hamzahaddaoui/Self-Balancing-Robot/Slides.pdf

## Robot auto bilanciante

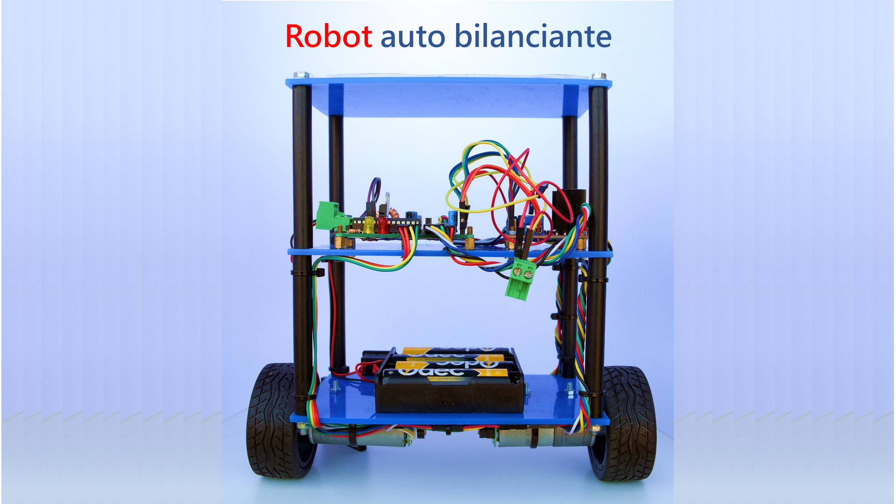
[picture p34: page 1]
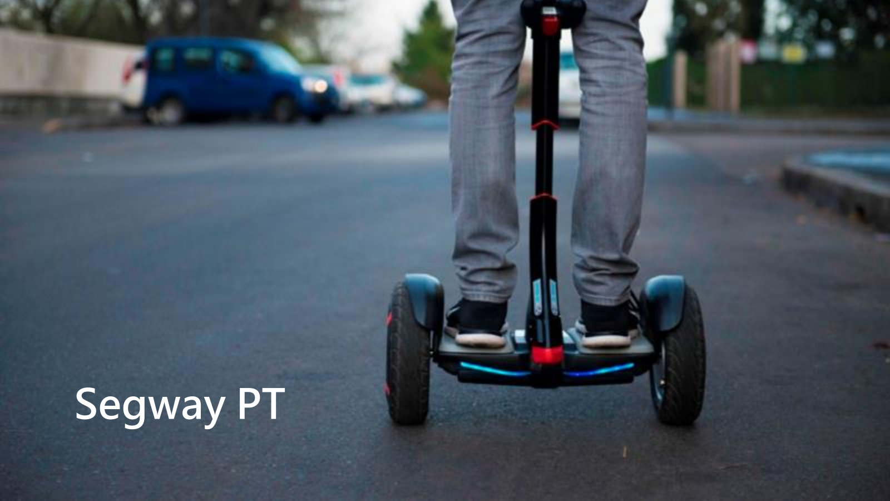
[picture p35: page 2]

# Segway PT

# Honda ASIMO

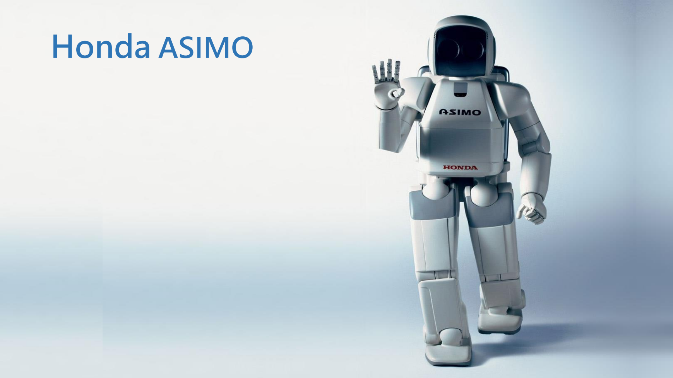
[picture p36: page 3]

# Balanduino

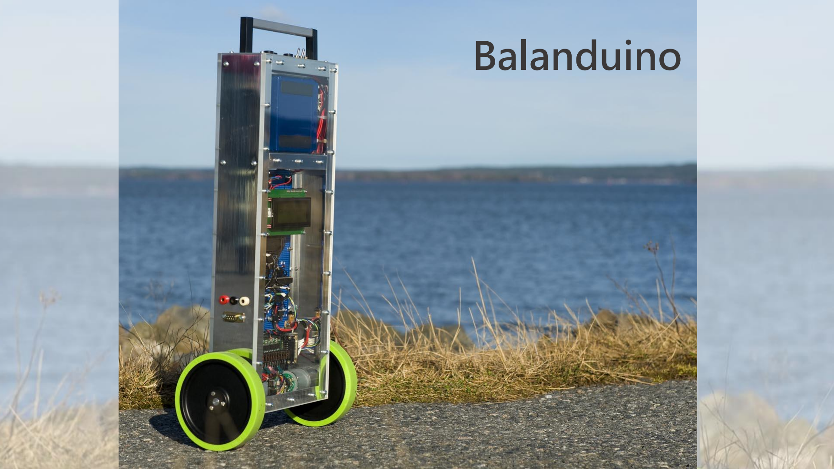
[picture p37: page 4]

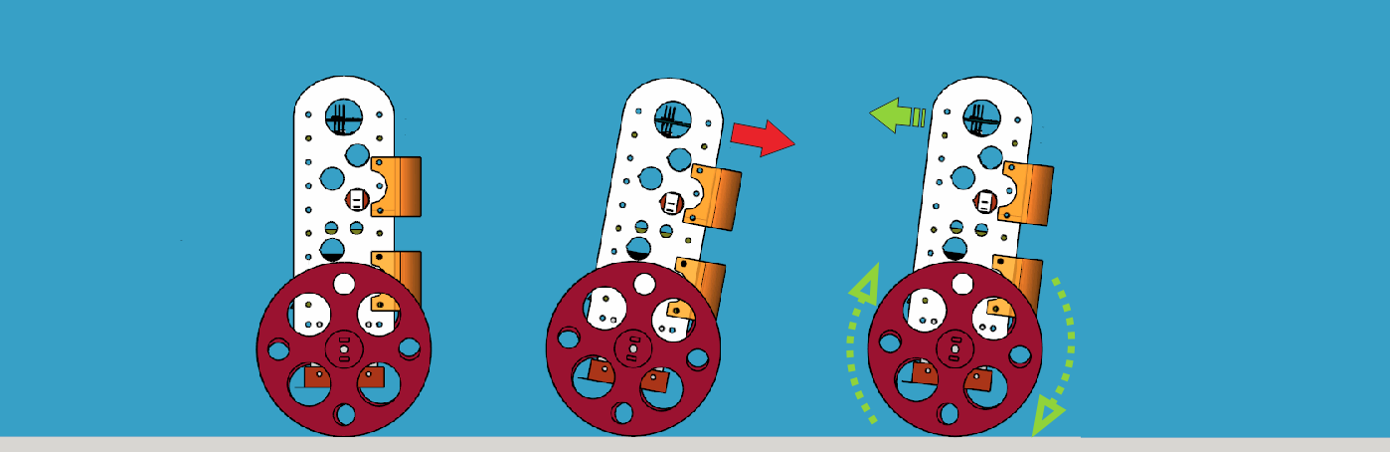
[picture p38: figure]

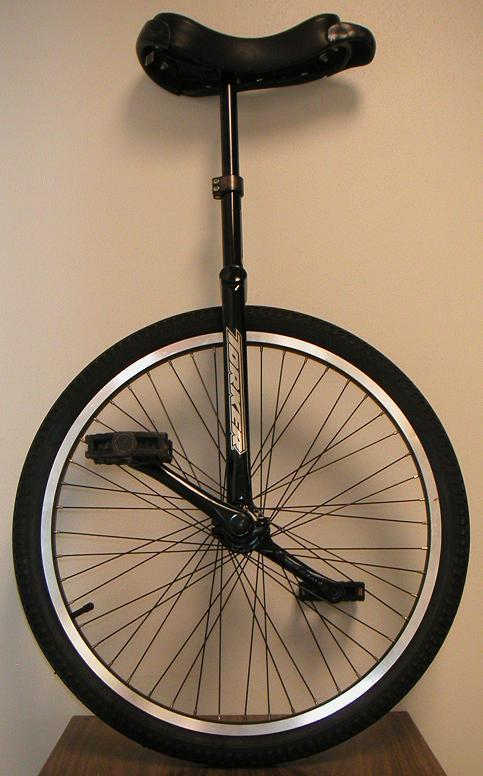
[picture p39: figure]
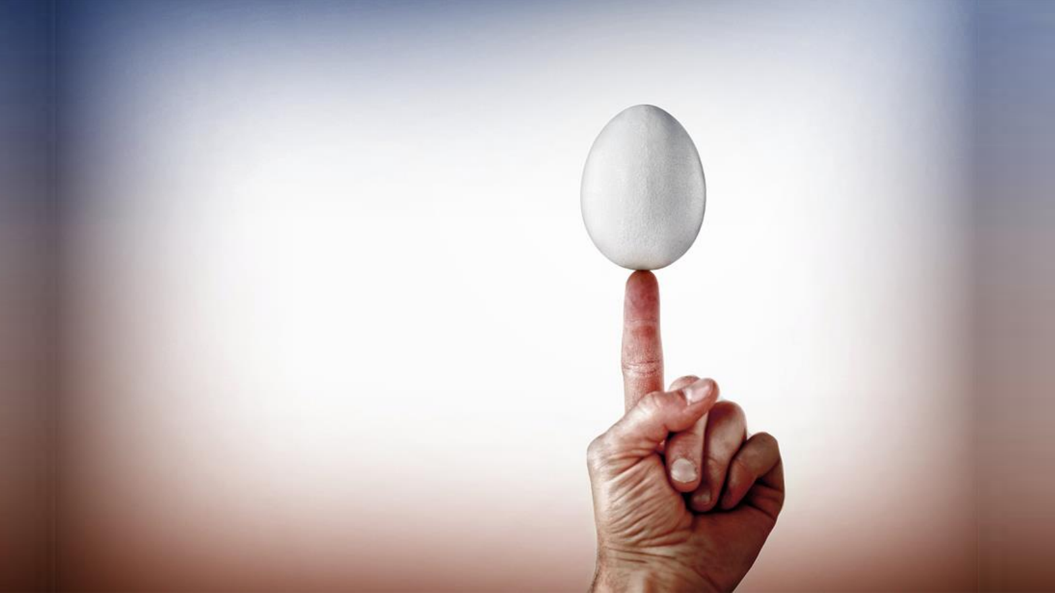
[picture p40: page 7]
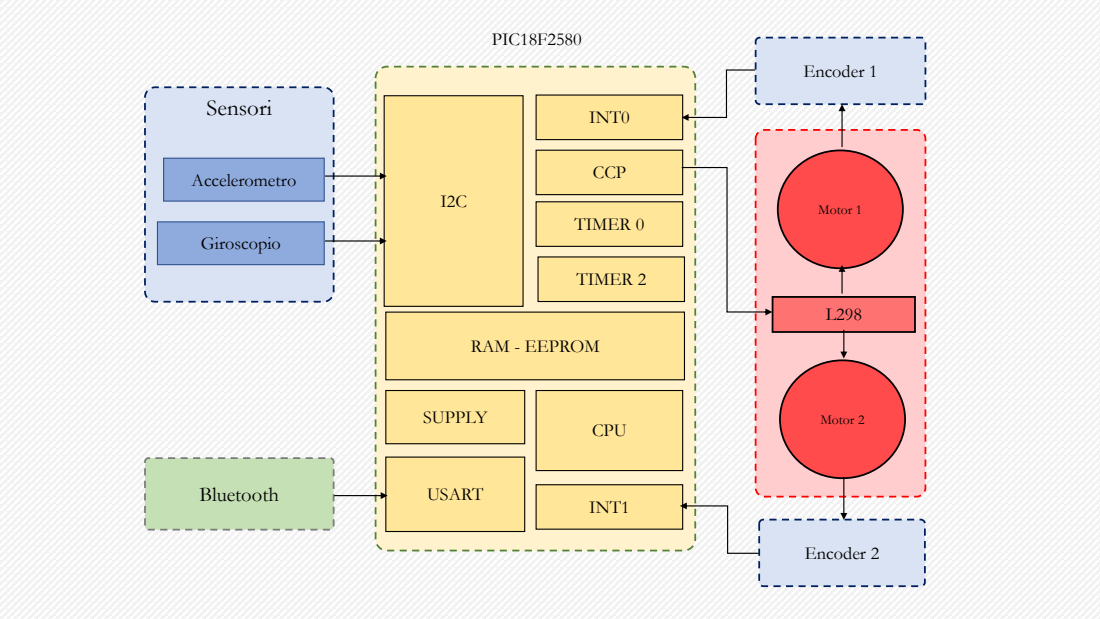
[picture p41: page 8]
Bluetooth; Encoder 1; Sensori; Accelerometro; Giroscopio; Motor 1; Motor 2; Encoder 2; USART; INT0; INT1; TIMER 0; CCP; TIMER 2; SUPPLY; RAM - EEPROM; CPU; PIC18F2580

# Sensori accelerometro e giroscopio

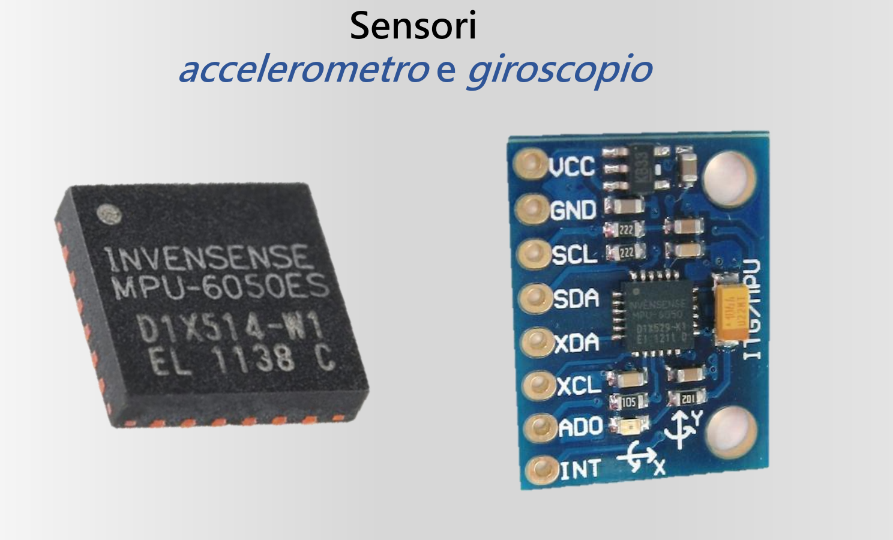
[picture p42: page 9]

# Scheda madre

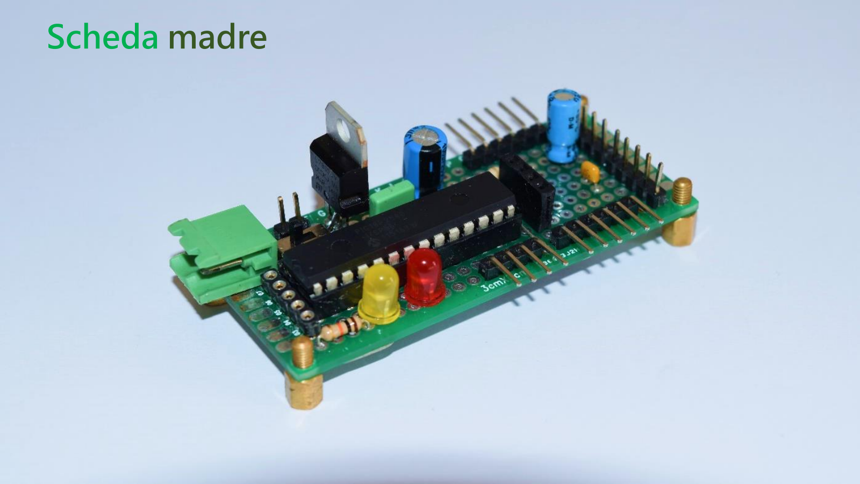
[picture p43: page 10]
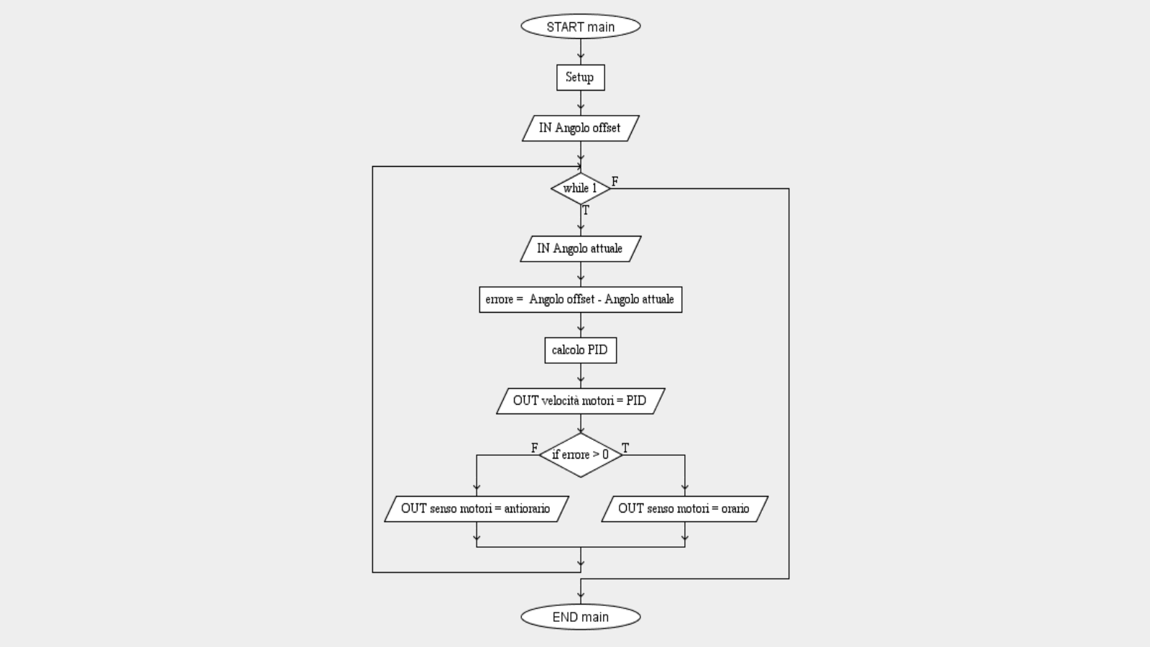
[picture p44: page 11]
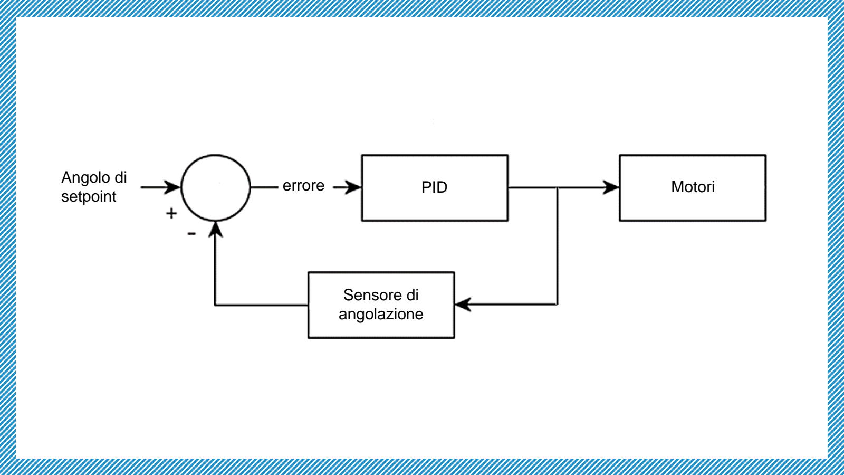
[picture p45: page 12]

errore Angolo di
setpoint | PID | Motori

Sensore di
angolazione

ACQUISIZIONE ACCELERAZIONE E VELOCITÀ ANGOLARE, E CONVERSIONE IN UN ANGOLO

θaccel = arctg

accx

accy

2 + accz

2

න θ ሶ
gyro t dt ≅ ෍

0

t
θ ሶ
gyro(t) ∙ tsample

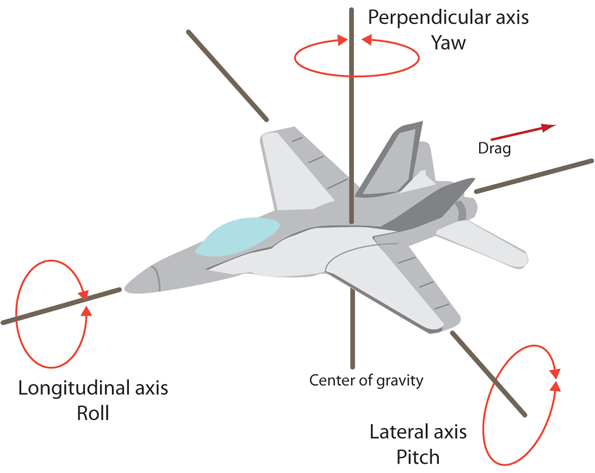
[picture p46: figure]

UNISCO I DATI CALCOLATI UTILIZZANDO IL FILTRO COMPLEMENTARE

θfilter = α ∙ θfilter + ሶ (θgyro t ∙ tsample + (1 − α) ∙ θaccel

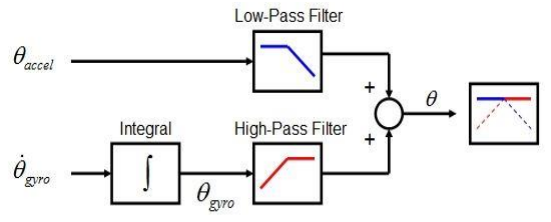
[picture p47: figure]
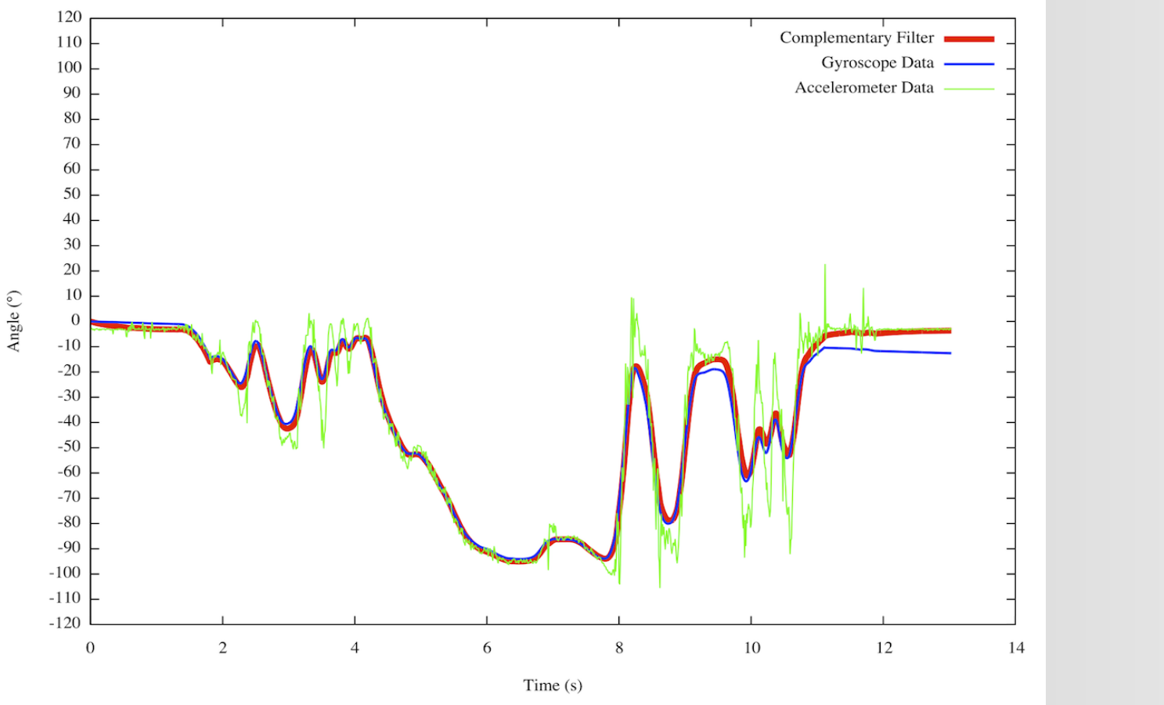
[picture p48: page 15]
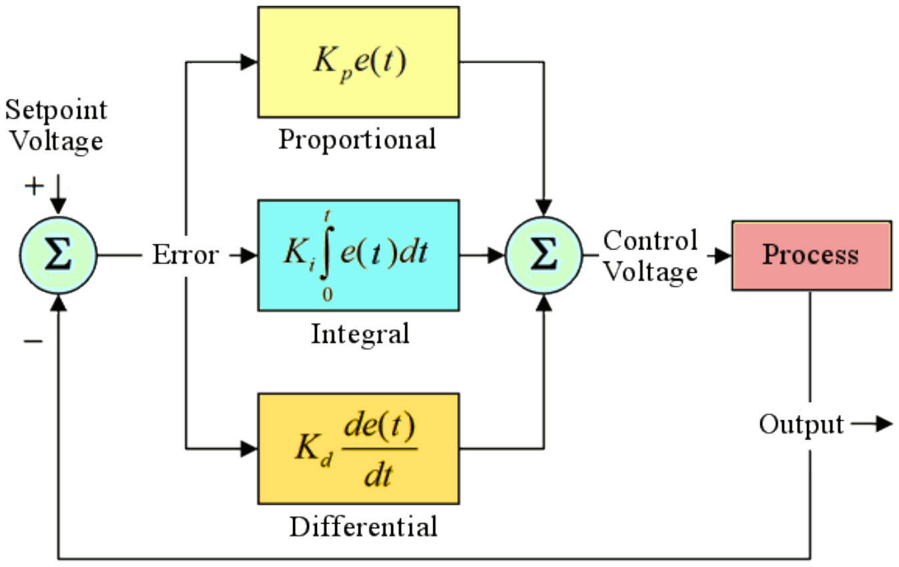
[picture p49: page 16]
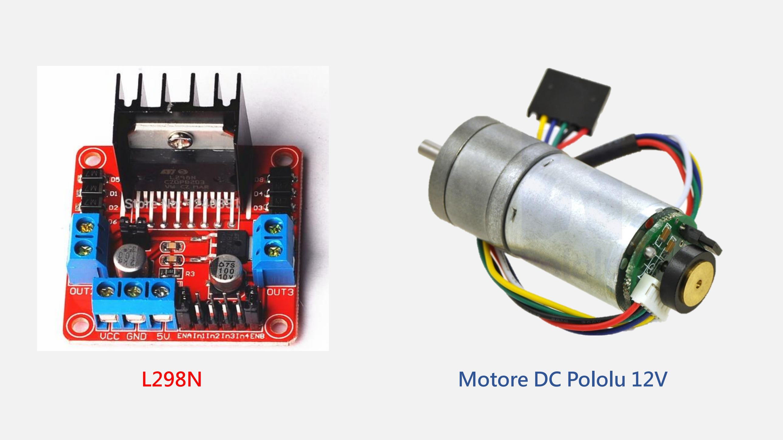
[picture p50: page 17]

L298N | Motore DC Pololu 12V

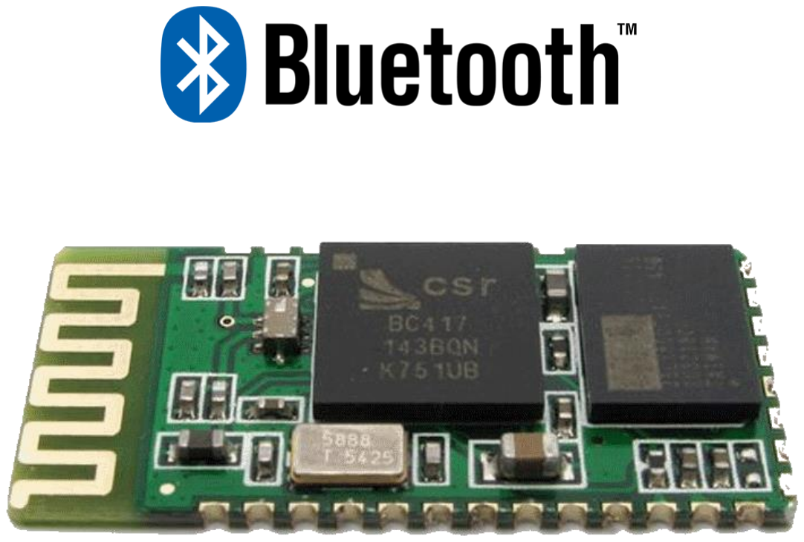
[picture p51: page 18]
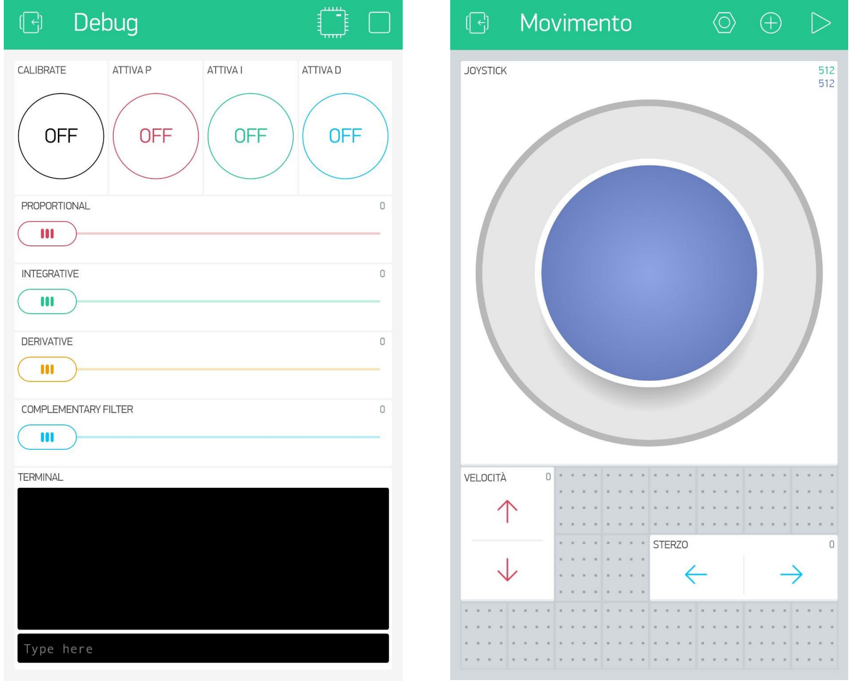
[picture p52: page 19]
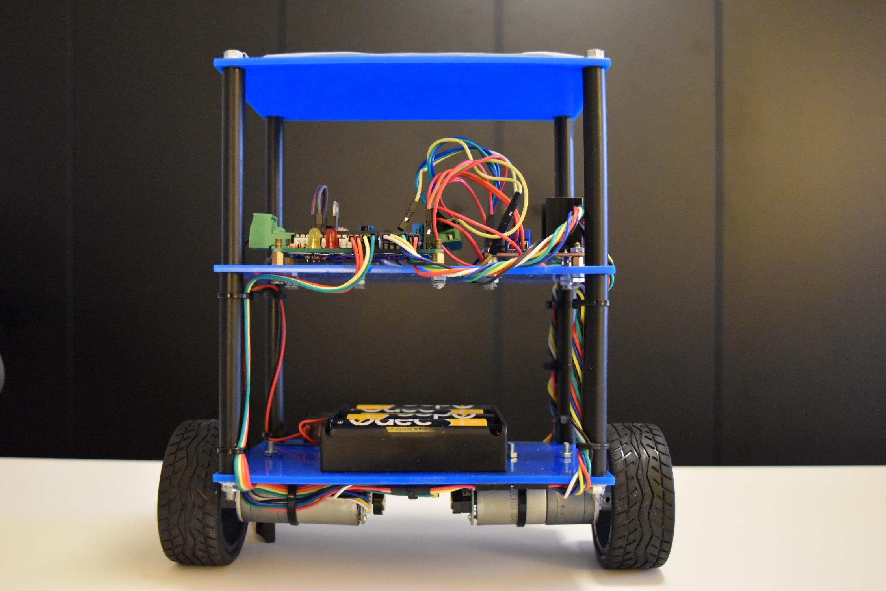
[picture p53: page 20]
