hamzahaddaoui/Self-Balancing-Robot/Pictures/Picture 5.png

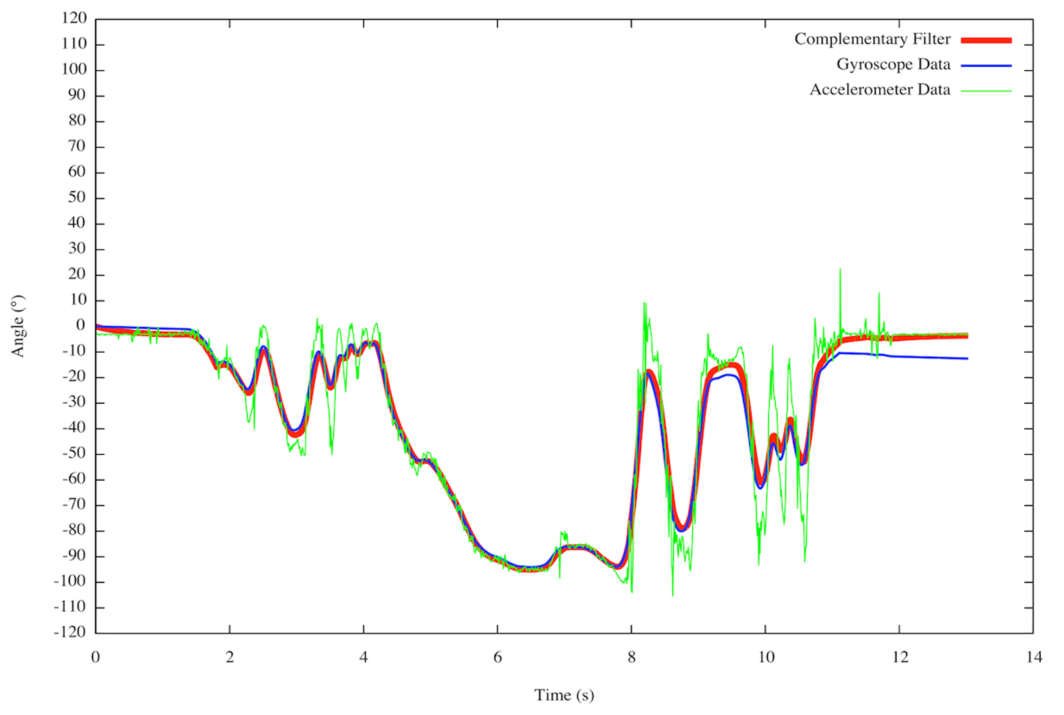
Pictures/Picture 5.png
