hamzahaddaoui/Self-Balancing-Robot/(list of files, cad)

Other CAD files:
Self Balancing Robot v3.0/startup.obj
Self Balancing Robot v3.0/project.obj
